rrh75/8052-BASIC-SBC/documentation/AT89C52_sbc_basic.pdf

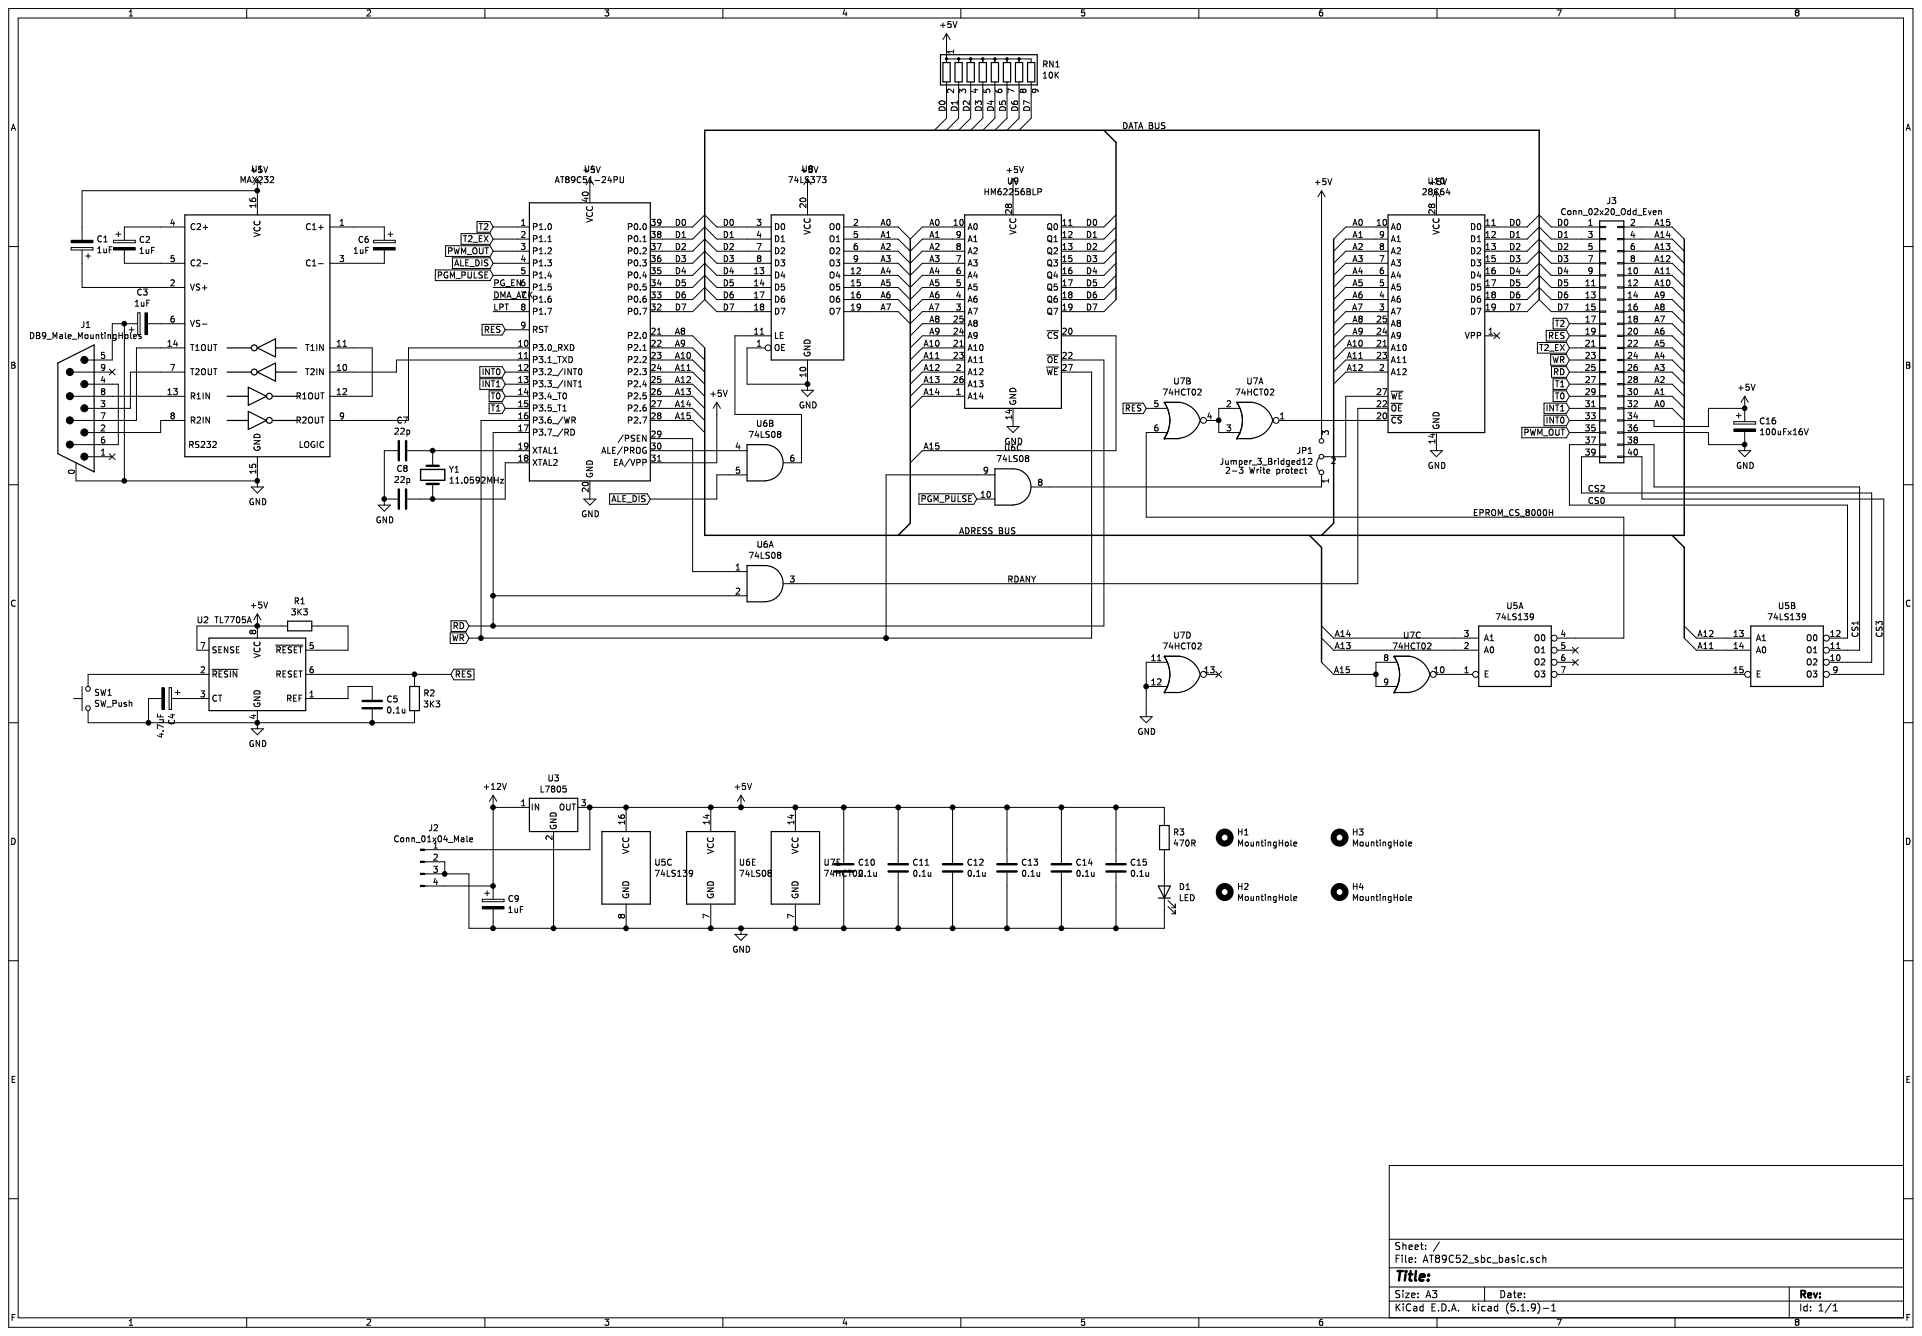
[picture p2: page 1]
