rrh75/8052-BASIC-SBC/documentation/AT89C52_sbc_basic_pcb.pdf

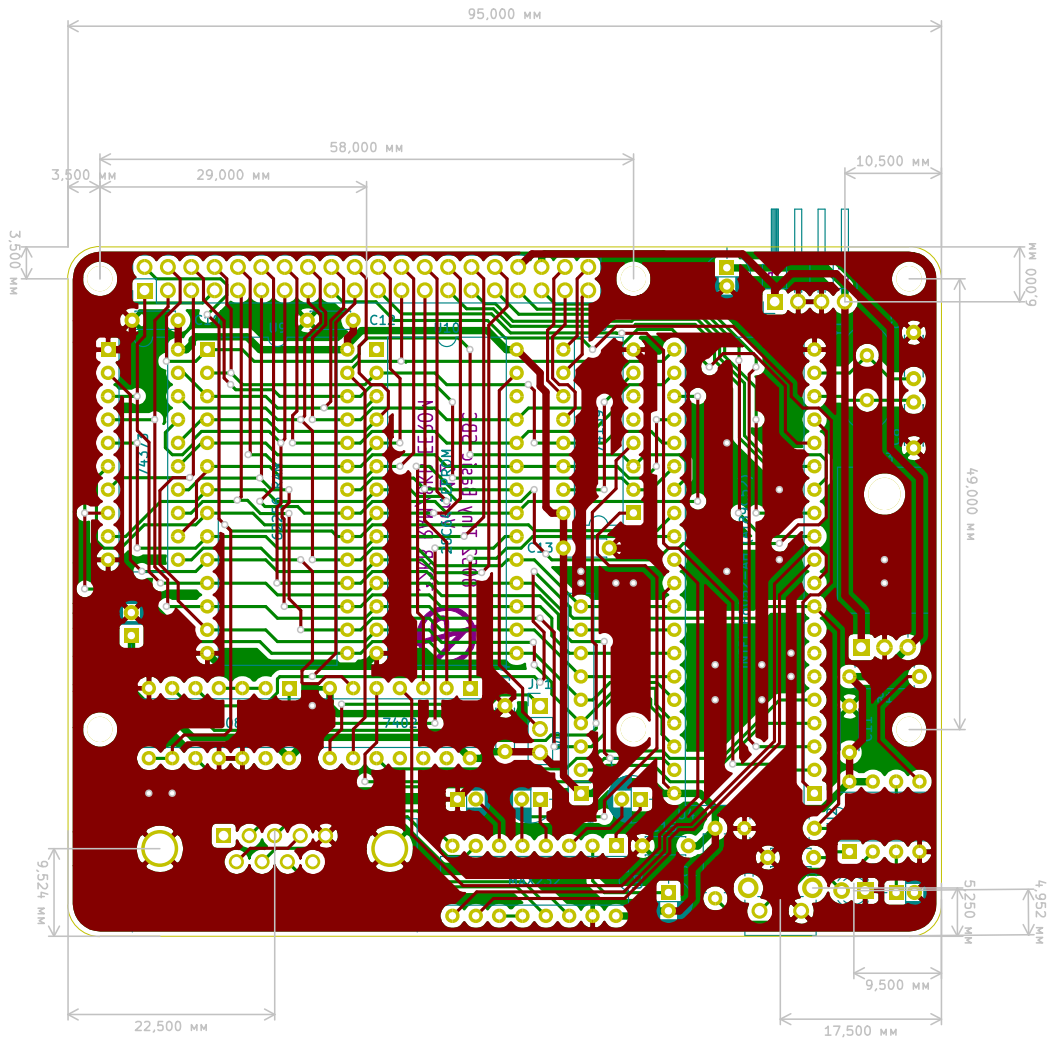
[picture p3: page 1]
