rrh75/8052-BASIC-SBC/AT89C52_sbc_basic.kicad_pcb

## KiCad design AT89C52_sbc_basic.kicad_pcb (2026-10-19)

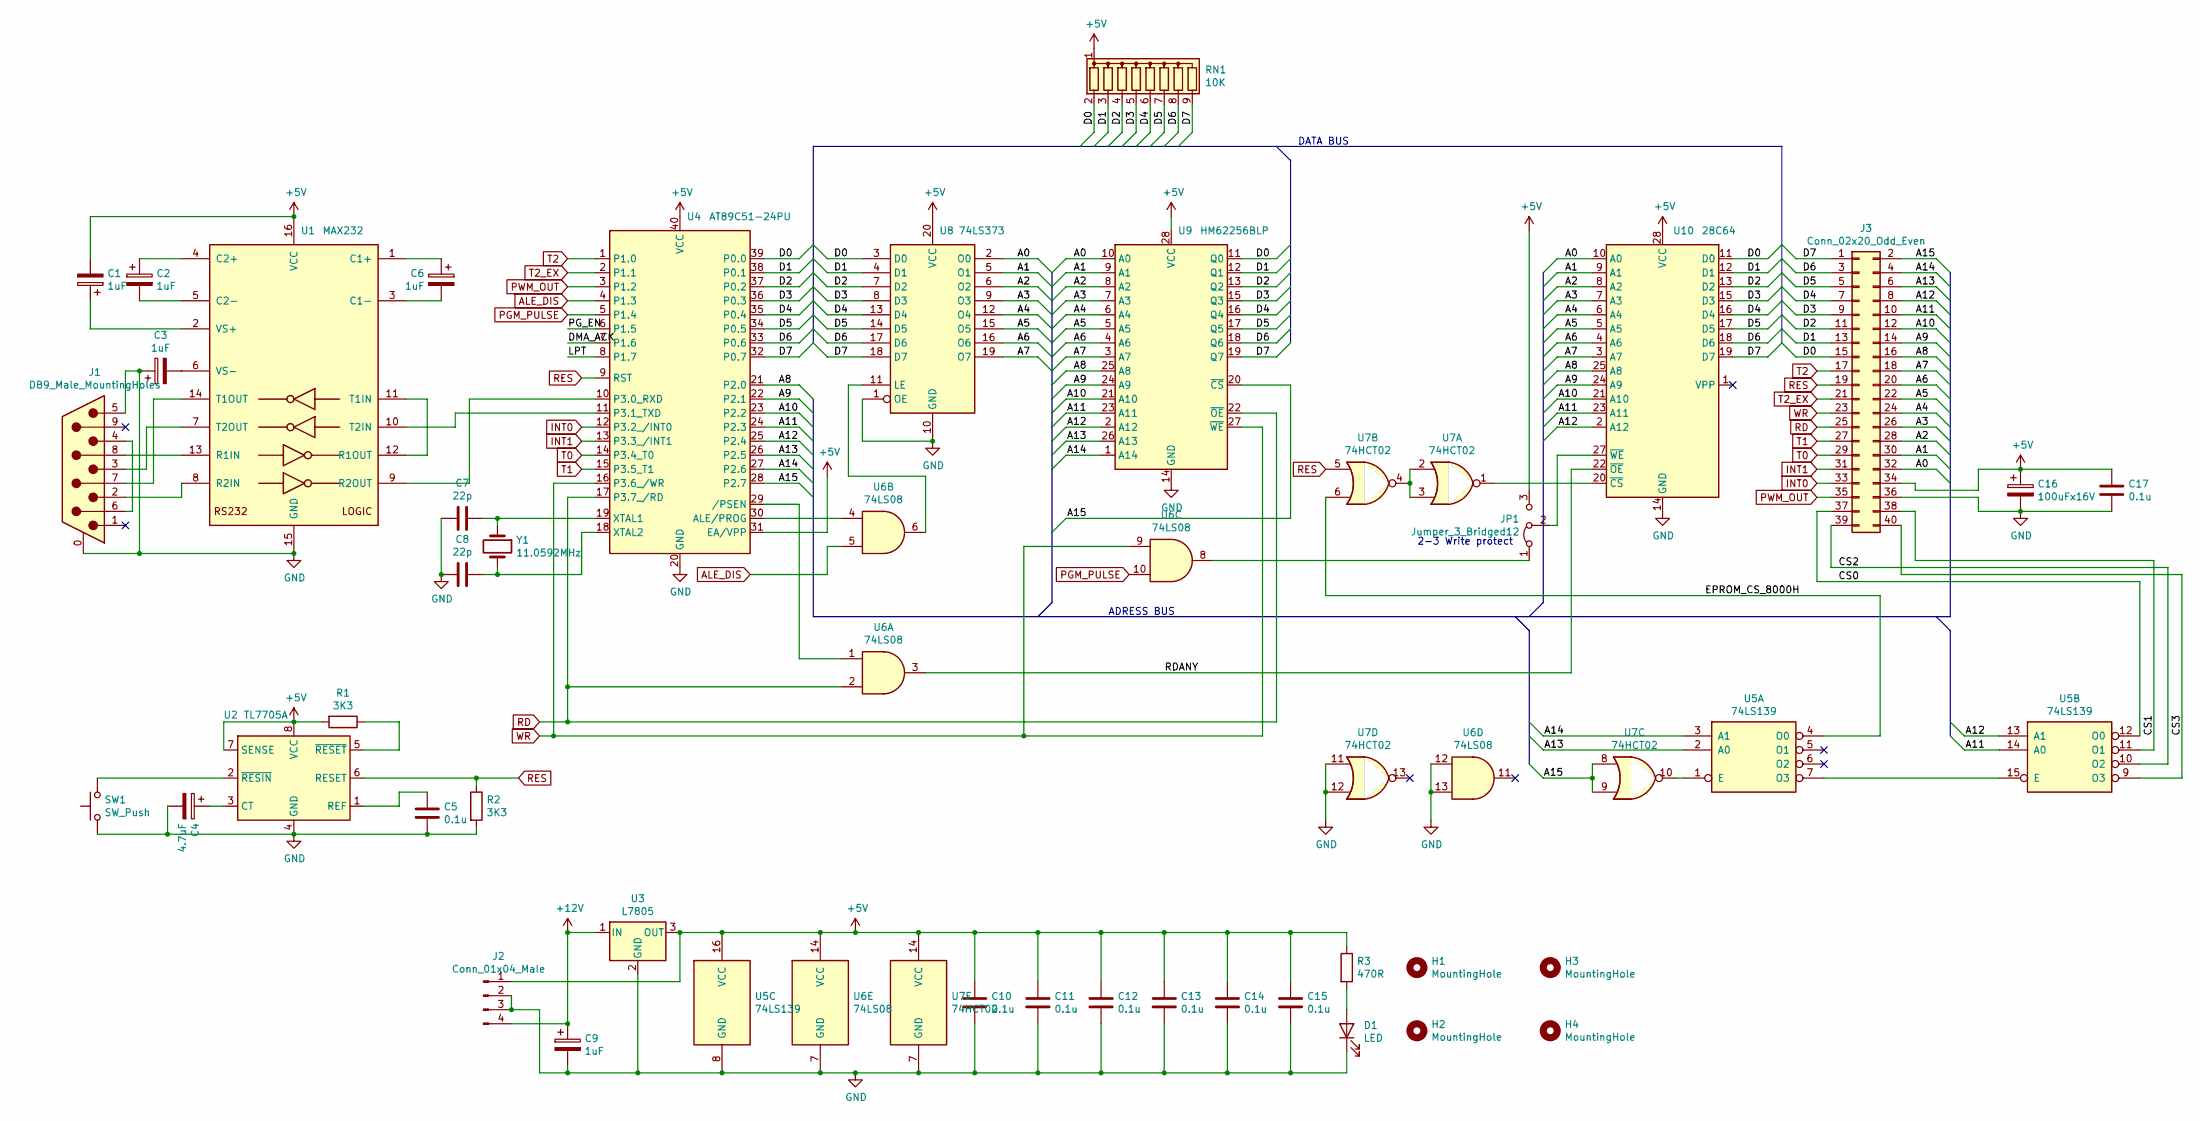
[picture p4: schematic AT89C52_sbc_basic.sch]

Parts:
C1, C2, C3, C6, C9: 1uF; CP_Radial_D5.0mm_P2.00mm
C4: 4.7uF; CP_Radial_D5.0mm_P2.00mm
C5, C10, C11, C12, C13, C14, C15, C17: 0.1u; C_Disc_D4.3mm_W1.9mm_P5.00mm
C7, C8: 22p; C_Disc_D4.3mm_W1.9mm_P5.00mm
C16: 100uFx16V; CP_Radial_D6.3mm_P2.50mm
D1: LED; LED_D3.0mm
H1, H2, H3, H4: MountingHole; MountingHole_2.7mm_M2.5
J1: DB9_Male_MountingHoles; DSUB-9_Male_Horizontal_P2.77x2.84mm_EdgePinOffset7.70mm_Hou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
J2: Conn_01x04_Male; Pin_Header_Angled_1x04_Pitch2.54mm
J3: Conn_02x20_Odd_Even; Pin_Header_Straight_2x20_Pitch2.54mm
JP1: Jumper_3_Bridged12; Pin_Header_Straight_1x03_Pitch2.54mm
R1, R2: 3K3; R_Axial_DIN0207_L6.3mm_D2.5mm_P7.62mm_Horizontal
R3: 470R; R_Axial_DIN0207_L6.3mm_D2.5mm_P7.62mm_Horizontal
RN1: 10K; R_Array_SIP9
SW1: SW_Push; SW_Tactile_SKHH_Angled
U1: MAX232; DIP-16_W7.62mm
U2: TL7705A; DIP-8_W7.62mm
U3: L7805; TO-220-3_Horizontal
U4: AT89C51-24PU; DIP-40_W15.24mm
U5: 74LS139; DIP-16_W7.62mm
U6: 74LS08; DIP-14_W7.62mm
U7: 74HCT02; DIP-14_W7.62mm
U8: 74LS373; DIP-20_W7.62mm
U9: HM62256BLP; DIP-28_W15.24mm
U10: 28C64; DIP-28_W15.24mm
Y1: 11.0592MHz; Crystal_HC49-U_Vertical

Connections:
+5V: C1.2, C10.1, C11.1, C12.1, C13.1, C14.1, C15.1, C16.1, C17.1, J2.1, J3.34, JP1.3 (B), R1.2, R3.1, RN1.1 (common), U1.16 (VCC), U2.7 (SENSE), U2.8 (VCC), U3.3 (OUT), U4.31 (EA/VPP), U4.40 (VCC), U5.16 (VCC), U6.14 (VCC), U7.14 (VCC), U8.20 (VCC), U9.28 (VCC), U10.28 (VCC)
+12V: C9.1, J2.4, U3.1 (IN)
/A0: J3.32, U8.2 (O0), U9.10 (A0), U10.10 (A0)
/A1: J3.30, U8.5 (O1), U9.9 (A1), U10.9 (A1)
/A2: J3.28, U8.6 (O2), U9.8 (A2), U10.8 (A2)
/A3: J3.26, U8.9 (O3), U9.7 (A3), U10.7 (A3)
/A4: J3.24, U8.12 (O4), U9.6 (A4), U10.6 (A4)
/A5: J3.22, U8.15 (O5), U9.5 (A5), U10.5 (A5)
/A6: J3.20, U8.16 (O6), U9.4 (A6), U10.4 (A6)
/A7: J3.18, U8.19 (O7), U9.3 (A7), U10.3 (A7)
/A8: J3.16, U4.21 (P2.0), U9.25 (A8), U10.25 (A8)
/A9: J3.14, U4.22 (P2.1), U9.24 (A9), U10.24 (A9)
/A10: J3.12, U4.23 (P2.2), U9.21 (A10), U10.21 (A10)
/A11: J3.10, U4.24 (P2.3), U5.14 (A0), U9.23 (A11), U10.23 (A11)
/A12: J3.8, U4.25 (P2.4), U5.13 (A1), U9.2 (A12), U10.2 (A12)
/A13: J3.6, U4.26 (P2.5), U5.2 (A0), U9.26 (A13)
/A14: J3.4, U4.27 (P2.6), U5.3 (A1), U9.1 (A14)
/A15: J3.2, U4.28 (P2.7), U7.8, U7.9, U9.20 (~CS)
/CS0: J3.37, U5.12 (O0)
/CS1: J3.38, U5.11 (O1)
/CS2: J3.39, U5.10 (O2)
/CS3: J3.40, U5.9 (O3)
/D0: J3.15, RN1.2 (R1), U4.39 (P0.0), U8.3 (D0), U9.11 (Q0), U10.11 (D0)
/D1: J3.13, RN1.3 (R2), U4.38 (P0.1), U8.4 (D1), U9.12 (Q1), U10.12 (D1)
/D2: J3.11, RN1.4 (R3), U4.37 (P0.2), U8.7 (D2), U9.13 (Q2), U10.13 (D2)
/D3: J3.9, RN1.5 (R4), U4.36 (P0.3), U8.8 (D3), U9.15 (Q3), U10.15 (D3)
/D4: J3.7, RN1.6 (R5), U4.35 (P0.4), U8.13 (D4), U9.16 (Q4), U10.16 (D4)
/D5: J3.5, RN1.7 (R6), U4.34 (P0.5), U8.14 (D5), U9.17 (Q5), U10.17 (D5)
/D6: J3.3, RN1.8 (R7), U4.33 (P0.6), U8.17 (D6), U9.18 (Q6), U10.18 (D6)
/D7: J3.1, RN1.9 (R8), U4.32 (P0.7), U8.18 (D7), U9.19 (Q7), U10.19 (D7)
/EPROM_CS_8000H: U5.4 (O0), U7.6
/RDANY: U6.3, U10.22 (~OE)
ALE_DIS: U4.4 (P1.3), U6.5
GND: C3.1, C4.2, C5.2, C7.2, C8.2, C9.2, C10.2, C11.2, C12.2, C13.2, C14.2, C15.2, C16.2, C17.2, D1.1 (K), J1.0 (PAD), J1.5, J2.2, J2.3, J3.36, R2.2, SW1.1, U1.15 (GND), U2.4 (GND), U3.2 (GND), U4.20 (GND), U5.8 (GND), U6.7 (GND), U6.12, U6.13, U7.7 (GND), U7.11, U7.12, U8.1 (OE), U8.10 (GND), U9.14 (GND), U10.14 (GND)
INT0: J3.33, U4.12 (P3.2_/INT0)
INT1: J3.31, U4.13 (P3.3_/INT1)
unnamed: C1.1, U1.2 (VS+)
unnamed: C2.1, U1.4 (C2+)
unnamed: C2.2, U1.5 (C2-)
unnamed: C3.2, U1.6 (VS-)
unnamed: C4.1, U2.3 (CT)
unnamed: C5.1, U2.1 (REF)
unnamed: C6.1, U1.1 (C1+)
unnamed: C6.2, U1.3 (C1-)
unnamed: C7.1, U4.19 (XTAL1), Y1.1
unnamed: C8.1, U4.18 (XTAL2), Y1.2
unnamed: D1.2 (A), R3.2
unnamed: J1.2, U1.8 (R2IN)
unnamed: J1.3, U1.7 (T2OUT)
unnamed: J1.4, J1.6
unnamed: J1.7, U1.14 (T1OUT)
unnamed: J1.8, U1.13 (R1IN)
unnamed: JP1.1 (A), U6.8
unnamed: JP1.2 (C), U10.27 (~WE)
unnamed: R1.1, U2.5 (~RESET)
unnamed: SW1.2, U2.2 (~RESIN)
unnamed: U1.9 (R2OUT), U4.10 (P3.0_RXD)
unnamed: U1.10 (T2IN), U4.11 (P3.1_TXD)
unnamed: U1.11 (T1IN), U1.12 (R1OUT)
unnamed: U4.29 (/PSEN), U6.1
unnamed: U4.30 (ALE/PROG), U6.4
unnamed: U5.1 (E), U7.10
unnamed: U5.7 (O3), U5.15 (E)
unnamed: U6.6, U8.11 (LE)
unnamed: U7.2, U7.3, U7.4
unnamed: U7.1, U10.20 (~CS)
PGM_PULSE: U4.5 (P1.4), U6.10
PWM_OUT: J3.35, U4.3 (P1.2)
RD: J3.25, U4.17 (P3.7_/RD), U6.2, U9.22 (~OE)
RES: J3.19, R2.1, U2.6 (RESET), U4.9 (RST), U7.5
T0: J3.29, U4.14 (P3.4_T0)
T1: J3.27, U4.15 (P3.5_T1)
T2: J3.17, U4.1 (P1.0)
T2_EX: J3.21, U4.2 (P1.1)
WR: J3.23, U4.16 (P3.6_/WR), U6.9, U9.27 (~WE)

Notes on the sheet:
DATA BUS
ADRESS BUS
2-3 Write protect

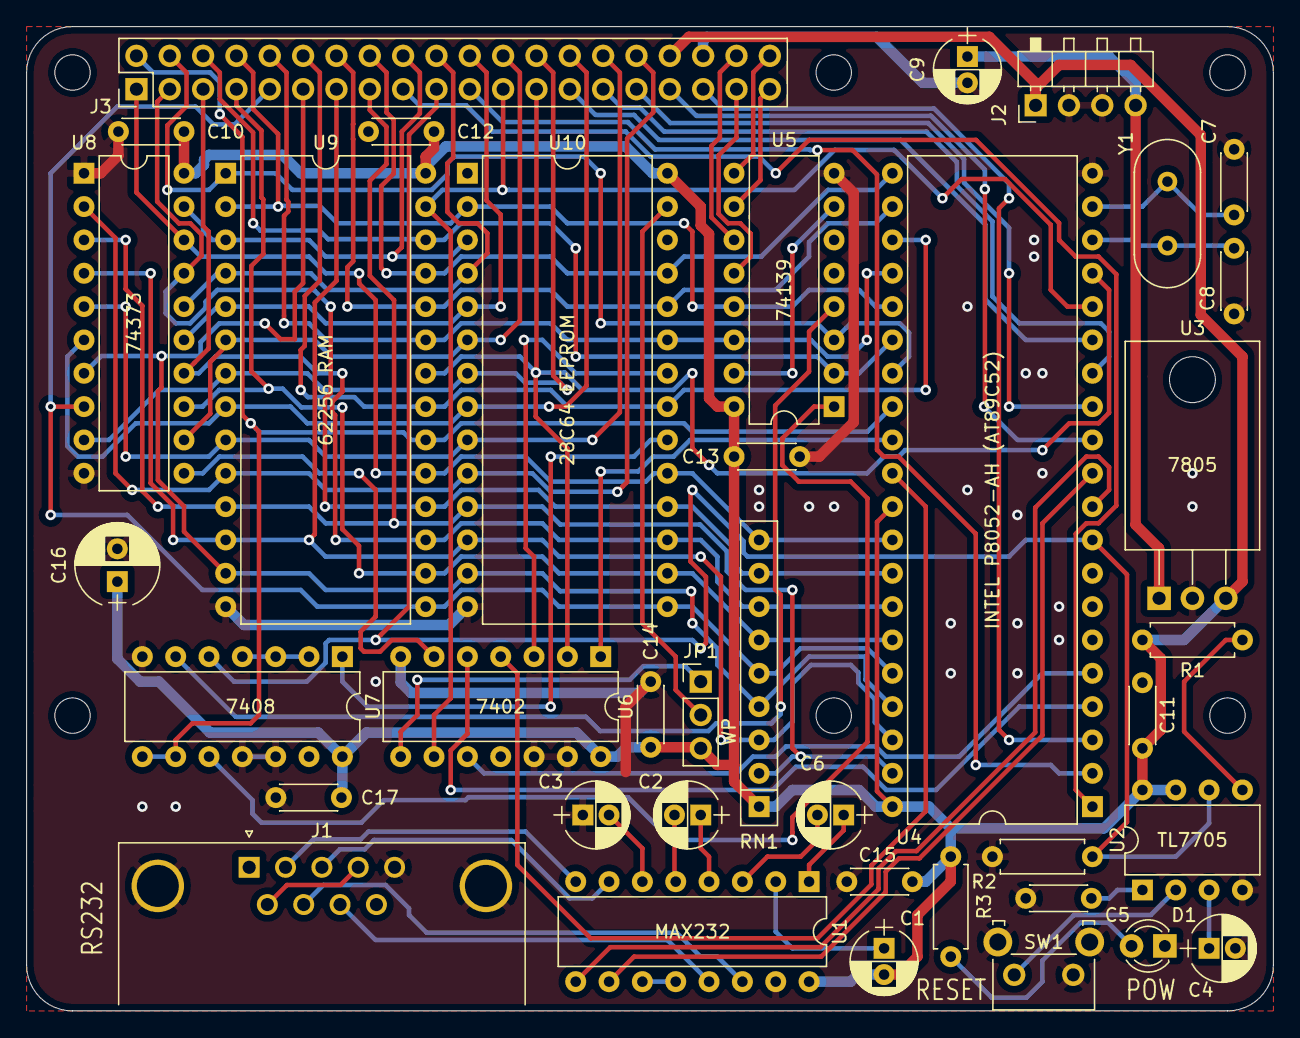
[picture p5: board AT89C52_sbc_basic.kicad_pcb from above]

Board: 2 copper layers, 95.0 x 75.0 mm, 44 parts (0 on the bottom side), 75 nets.

Other parts of the board:
H1#2, H2#2: MountingHole; MountingHole_2.7mm_M2.5
